pipebenitezpb1/PULSAR/docs/renders/perillas_variantes.png

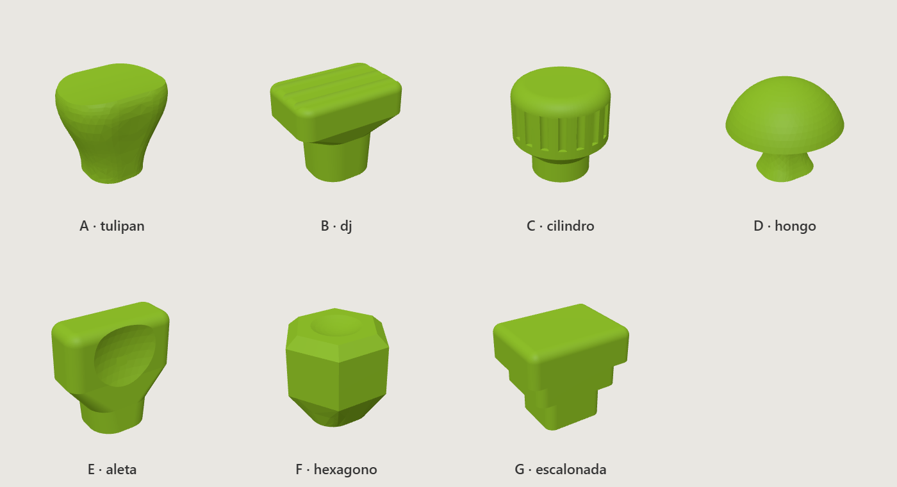
docs/renders/perillas_variantes.png
