pipebenitezpb1/PULSAR/docs/renders/vistaL_atras.png

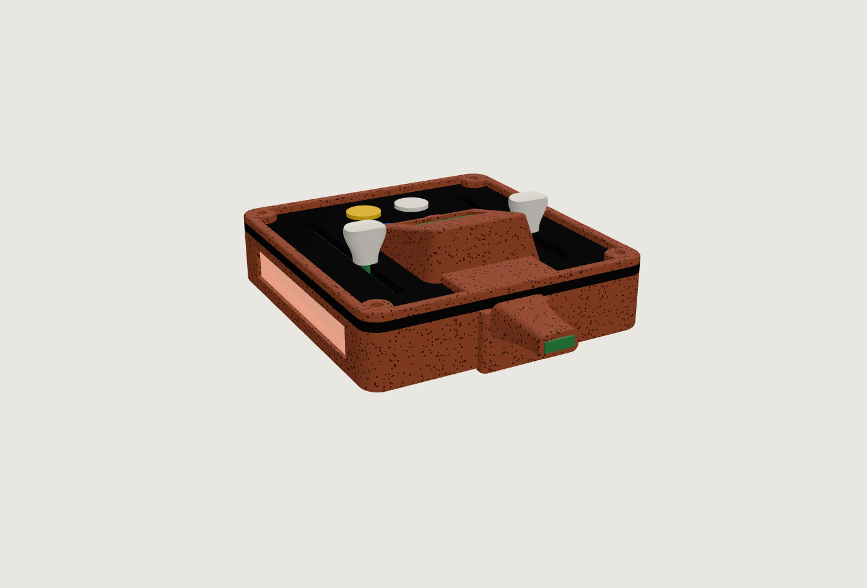
docs/renders/vistaL_atras.png
