pipebenitezpb1/PULSAR/fabricacion/impresion_3d/CTRL-04L_9_tapa_cuerpo.stl

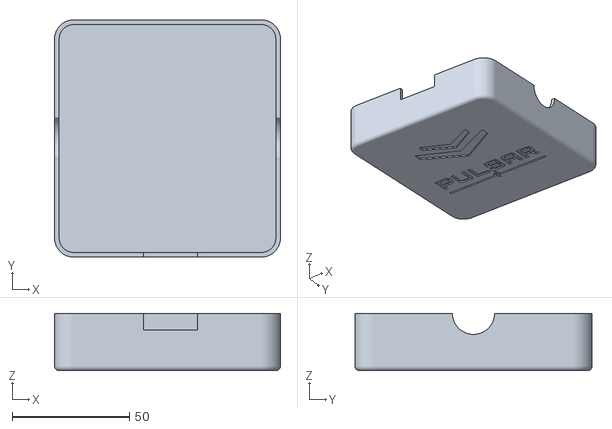
[picture p31: CAD file, 2026-10-29]
fabricacion/impresion_3d/CTRL-04L_9_tapa_cuerpo.stl
96.5 x 101.3 x 24.5
