pipebenitezpb1/PULSAR/fabricacion/laser/CTRL-04L_acrilico_3mm.step

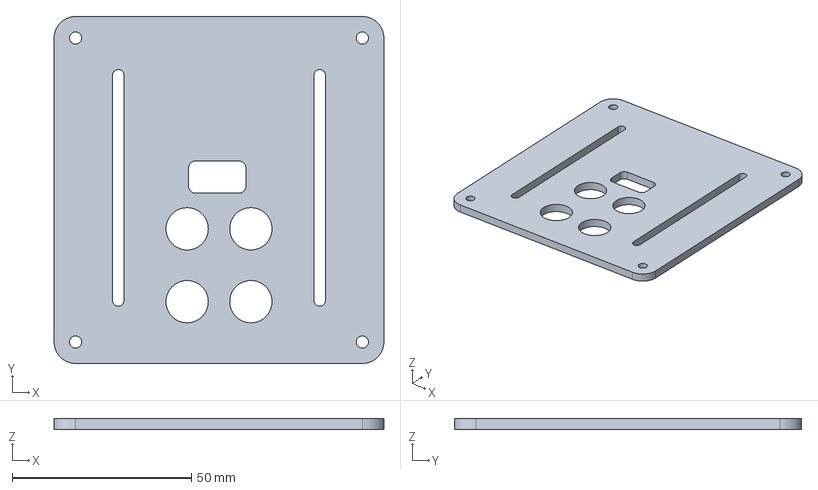
[picture p32: CAD file, 2026-10-29]
fabricacion/laser/CTRL-04L_acrilico_3mm.step
92.0 x 96.8 x 3.00 mm
