pipebenitezpb1/PULSAR/fabricacion/impresion_3d/CTRL-04L_9_tapa_acento.stl

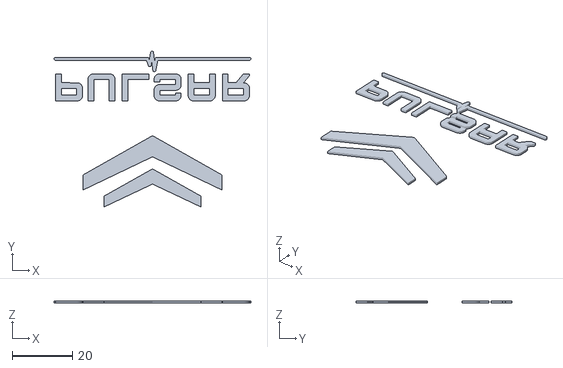
[picture p33: CAD file, 2026-10-29]
fabricacion/impresion_3d/CTRL-04L_9_tapa_acento.stl
65.3 x 51.6 x 0.8
