pipebenitezpb1/PULSAR/fabricacion/impresion_3d/CTRL-04L_9_tapa.step

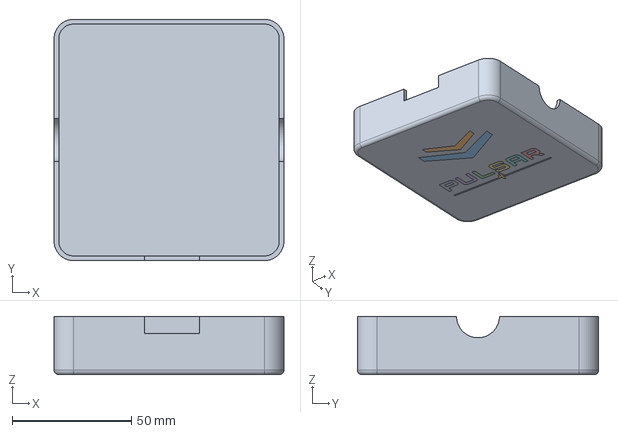
[picture p34: CAD file, 2026-10-29]
fabricacion/impresion_3d/CTRL-04L_9_tapa.step
96.5 x 101.3 x 24.5 mm
