pipebenitezpb1/PULSAR/fabricacion/impresion_3d/perilla_H_ala_cuerpo_x2.stl

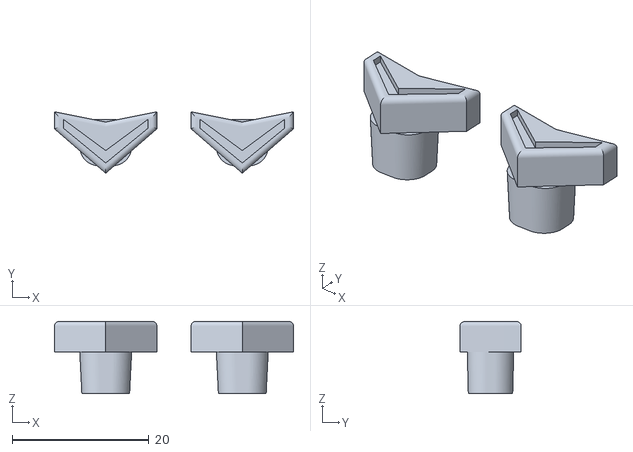
[picture p35: CAD file, 2026-10-29]
fabricacion/impresion_3d/perilla_H_ala_cuerpo_x2.stl
35.0 x 9.00 x 10.6
