pipebenitezpb1/PULSAR/fabricacion/impresion_3d/CTRL-04L_3_marco_oled.step

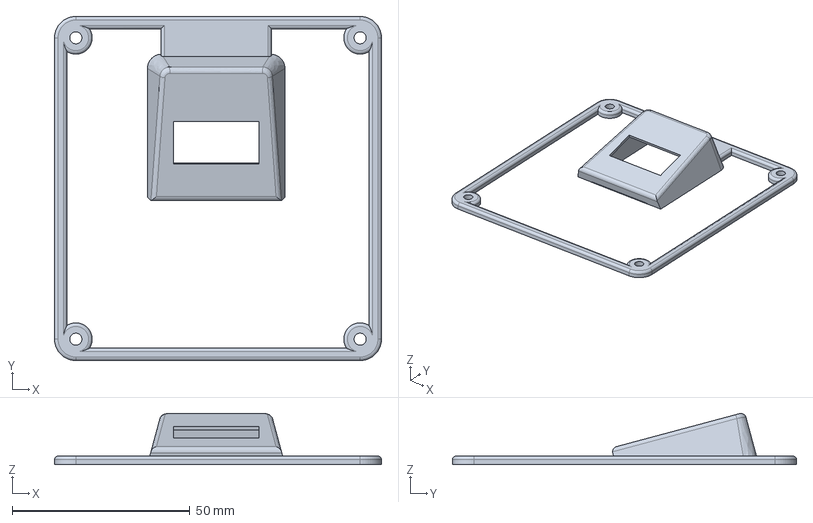
[picture p36: CAD file, 2026-10-29]
fabricacion/impresion_3d/CTRL-04L_3_marco_oled.step
92.0 x 96.8 x 14.4 mm
