pipebenitezpb1/PULSAR/fabricacion/impresion_3d/CTRL-04L_1_caja.step

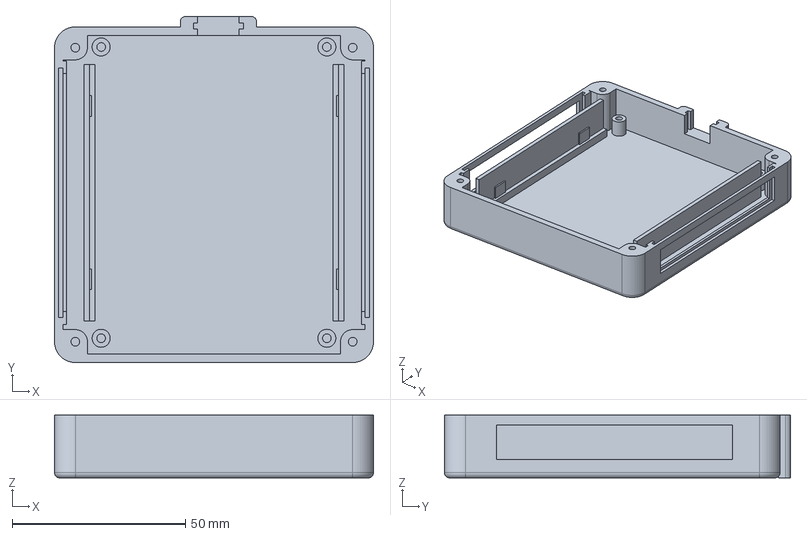
[picture p37: CAD file, 2026-10-29]
fabricacion/impresion_3d/CTRL-04L_1_caja.step
92.0 x 99.8 x 18.1 mm
