pipebenitezpb1/PULSAR/fabricacion/impresion_3d/perilla_H_ala_acento_x2.stl

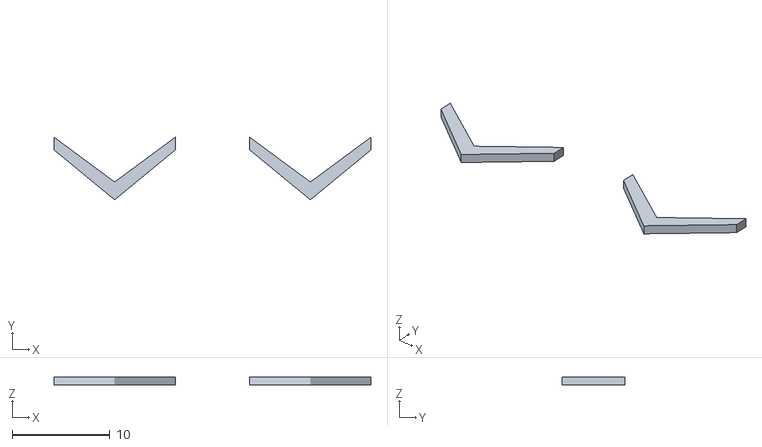
[picture p38: CAD file, 2026-10-29]
fabricacion/impresion_3d/perilla_H_ala_acento_x2.stl
32.4 x 6.40 x 0.8
