pipebenitezpb1/PULSAR/fabricacion/impresion_3d/perilla_H_ala_x2.step

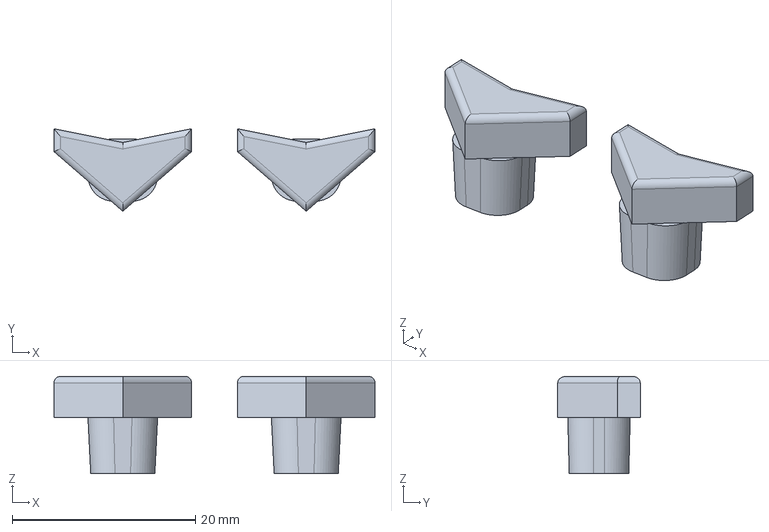
[picture p39: CAD file, 2026-10-29]
fabricacion/impresion_3d/perilla_H_ala_x2.step
35.0 x 9.00 x 10.6 mm
