pipebenitezpb1/PULSAR/fabricacion/impresion_3d/CTRL-04L_4_cuna_oled.step

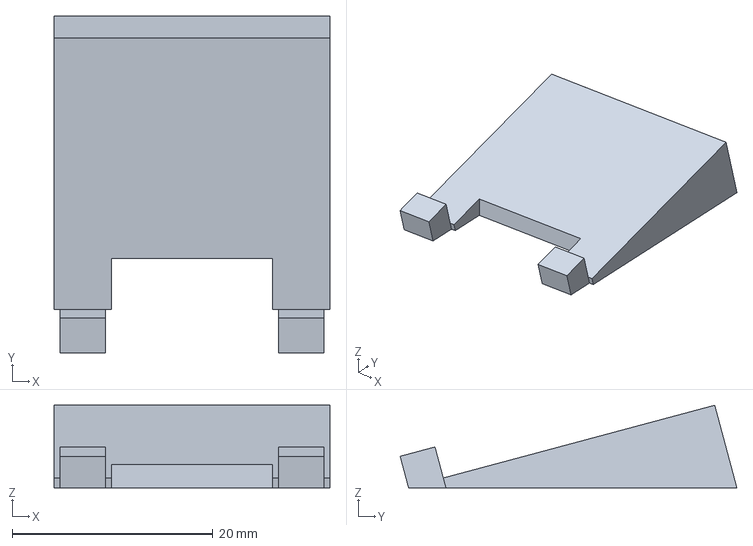
[picture p40: CAD file, 2026-10-29]
fabricacion/impresion_3d/CTRL-04L_4_cuna_oled.step
27.5 x 33.6 x 8.22 mm
