pipebenitezpb1/PULSAR/fabricacion/impresion_3d/CTRL-04L_8_patas_tpu_x6.step

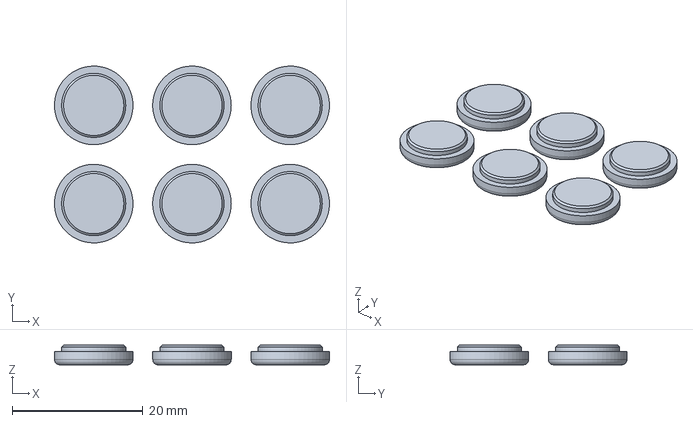
[picture p41: CAD file, 2026-10-29]
fabricacion/impresion_3d/CTRL-04L_8_patas_tpu_x6.step
42.0 x 27.0 x 3.00 mm
