pipebenitezpb1/PULSAR/fabricacion/impresion_3d/CTRL-04L_7_funda_usb.step

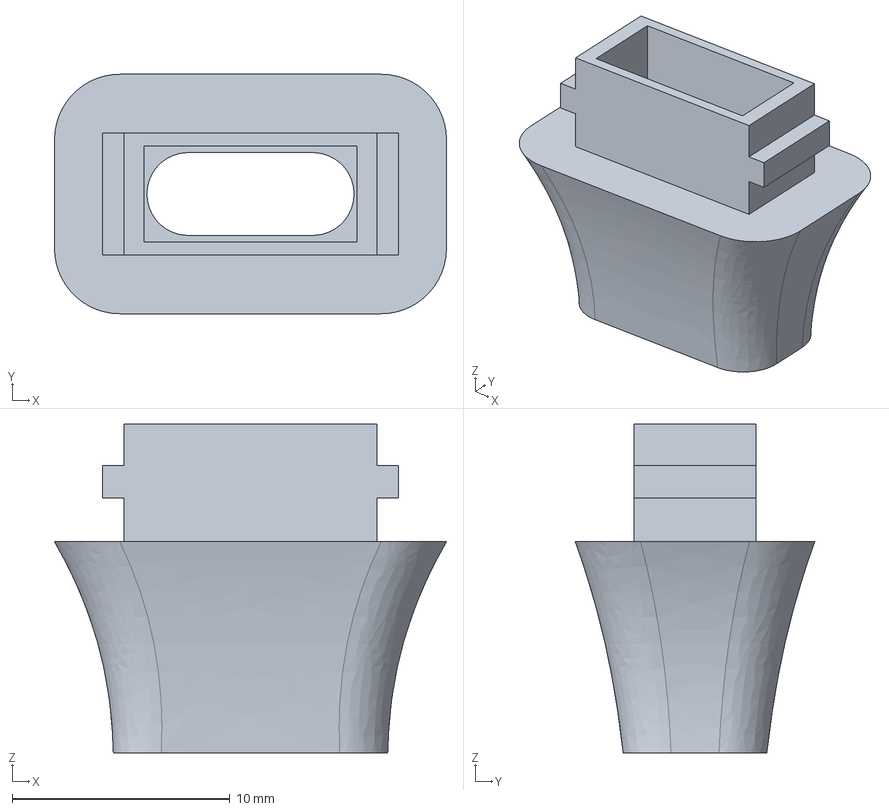
[picture p42: CAD file, 2026-10-29]
fabricacion/impresion_3d/CTRL-04L_7_funda_usb.step
18.0 x 11.0 x 15.1 mm
