pipebenitezpb1/PULSAR/fabricacion/impresion_3d/CTRL-04L_5_lamina_difusora_x2.stl

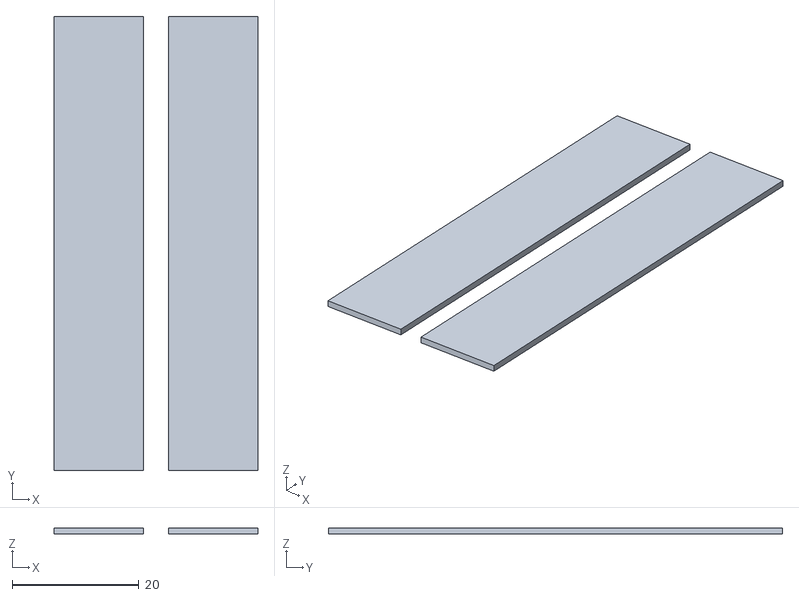
[picture p43: CAD file, 2026-10-29]
fabricacion/impresion_3d/CTRL-04L_5_lamina_difusora_x2.stl
32.1 x 71.6 x 1.00
