pipebenitezpb1/PULSAR/(list of files, cad)

Other CAD files:
fabricacion/impresion_3d/CTRL-04L_1_caja.stl
fabricacion/impresion_3d/CTRL-04L_3_marco_oled.stl
fabricacion/impresion_3d/CTRL-04L_4_cuna_oled.stl
fabricacion/impresion_3d/CTRL-04L_7_funda_usb.stl
fabricacion/impresion_3d/CTRL-04L_8_patas_tpu_x6.stl
fabricacion/laser/CTRL-04L_acrilico_3mm.dxf
