pipebenitezpb1/PULSAR/firmware/src/logo_pulsar.h

// Logo PULSAR para la OLED (generado por avanzado/logo.py, no editar a mano)
#pragma once
const int LOGO_W = 120, LOGO_H = 34;
static const unsigned char LOGO_BITS[] PROGMEM = {
  0xfe, 0xff, 0xe0, 0x01, 0x3c, 0x1e, 0x00, 0x80, 0xff, 0x0f, 0xf0, 0xff, 0x81, 0xff, 0x3f,
  0xfe, 0xff, 0xe1, 0x01, 0x3c, 0x1e, 0x00, 0xe0, 0xff, 0x1f, 0xf8, 0xff, 0x83, 0xff, 0x7f,
  0xfe, 0xff, 0xe1, 0x01, 0x3c, 0x1e, 0x00, 0xe0, 0xff, 0x1f, 0xfc, 0xff, 0x83, 0xff, 0x7f,
  0x1e, 0xc0, 0xe3, 0x01, 0x3c, 0x1e, 0x00, 0xe0, 0x01, 0x3c, 0x3c, 0x80, 0x87, 0x07, 0xf0,
  0x1e, 0xc0, 0xe3, 0x01, 0x3c, 0x1e, 0x00, 0xe0, 0x01, 0x1c, 0x3c, 0x80, 0x87, 0x07, 0xf0,
  0x1e, 0xc0, 0xe3, 0x01, 0x3c, 0x1e, 0x00, 0xe0, 0x01, 0x00, 0x3c, 0x80, 0x87, 0x07, 0xf0,
  0x1e, 0xc0, 0xe3, 0x01, 0x3c, 0x1e, 0x00, 0xe0, 0xff, 0x0f, 0x3c, 0x80, 0x87, 0x07, 0xf0,
  0xfe, 0xff, 0xe3, 0x01, 0x3c, 0x1e, 0x00, 0xe0, 0xff, 0x1f, 0x3c, 0x80, 0x87, 0xff, 0xff,
  0xfe, 0xff, 0xe1, 0x01, 0x3c, 0x1e, 0x00, 0xc0, 0xff, 0x1f, 0xfc, 0xff, 0x87, 0xff, 0x7f,
  0xfe, 0xff, 0xe1, 0x01, 0x3c, 0x1e, 0x00, 0x00, 0x00, 0x3c, 0xfc, 0xff, 0x87, 0xff, 0x7f,
  0x1e, 0x00, 0xe0, 0x01, 0x3c, 0x1e, 0x00, 0x00, 0x00, 0x3c, 0xfc, 0xff, 0x87, 0x87, 0x1f,
  0x1e, 0x00, 0xe0, 0x01, 0x3c, 0x1e, 0x00, 0xe0, 0x01, 0x3c, 0x3c, 0x80, 0x87, 0x07, 0x1f,
  0x1e, 0x00, 0xe0, 0x01, 0x3c, 0x1e, 0x00, 0xe0, 0x01, 0x3c, 0x3c, 0x80, 0x87, 0x07, 0x3e,
  0x1e, 0x00, 0xe0, 0xff, 0x1f, 0xfe, 0xff, 0xe3, 0xff, 0x1f, 0x3c, 0x80, 0x87, 0x07, 0x7c,
  0x1e, 0x00, 0xc0, 0xff, 0x1f, 0xfe, 0xff, 0xc3, 0xff, 0x1f, 0x3c, 0x80, 0x87, 0x07, 0x78,
  0x1e, 0x00, 0x80, 0xff, 0x0f, 0xfe, 0xff, 0x83, 0xff, 0x0f, 0x3c, 0x80, 0x87, 0x07, 0xf8,
  0x00, 0x00, 0x00, 0x00, 0x00, 0x00, 0x00, 0x00, 0x00, 0x00, 0x00, 0x00, 0x00, 0x00, 0x00,
  0x00, 0x00, 0x00, 0x00, 0x00, 0x00, 0x00, 0x00, 0x00, 0x00, 0x00, 0x00, 0x00, 0x00, 0x00,
  0x00, 0x00, 0x00, 0x00, 0x00, 0x00, 0x00, 0x00, 0x00, 0x00, 0x00, 0x00, 0x00, 0x00, 0x00,
  0x00, 0x00, 0x00, 0x00, 0x00, 0x00, 0x00, 0x20, 0x00, 0x00, 0x00, 0x00, 0x00, 0x00, 0x00,
  0x00, 0x00, 0x00, 0x00, 0x00, 0x00, 0x00, 0x20, 0x00, 0x00, 0x00, 0x00, 0x00, 0x00, 0x00,
  0x00, 0x00, 0x00, 0x00, 0x00, 0x00, 0x00, 0x20, 0x00, 0x00, 0x00, 0x00, 0x00, 0x00, 0x00,
  0x00, 0x00, 0x00, 0x00, 0x00, 0x00, 0x00, 0x34, 0x00, 0x00, 0x00, 0x00, 0x00, 0x00, 0x00,
  0x00, 0x00, 0x00, 0x00, 0x00, 0x00, 0x00, 0x54, 0x00, 0x00, 0x00, 0x00, 0x00, 0x00, 0x00,
  0x00, 0x00, 0x00, 0x00, 0x00, 0x00, 0x00, 0x56, 0x00, 0x00, 0x00, 0x00, 0x00, 0x00, 0x00,
  0x00, 0x00, 0x00, 0x00, 0x00, 0x00, 0x00, 0x56, 0x00, 0x00, 0x00, 0x00, 0x00, 0x00, 0x00,
  0xff, 0xff, 0xff, 0xff, 0xff, 0xff, 0xff, 0xd9, 0xff, 0xff, 0xff, 0xff, 0xff, 0xff, 0xff,
  0x00, 0x00, 0x00, 0x00, 0x00, 0x00, 0x00, 0x18, 0x00, 0x00, 0x00, 0x00, 0x00, 0x00, 0x00,
  0x00, 0x00, 0x00, 0x00, 0x00, 0x00, 0x00, 0x08, 0x00, 0x00, 0x00, 0x00, 0x00, 0x00, 0x00,
  0x00, 0x00, 0x00, 0x00, 0x00, 0x00, 0x00, 0x08, 0x00, 0x00, 0x00, 0x00, 0x00, 0x00, 0x00,
  0x00, 0x00, 0x00, 0x00, 0x00, 0x00, 0x00, 0x08, 0x00, 0x00, 0x00, 0x00, 0x00, 0x00, 0x00,
  0x00, 0x00, 0x00, 0x00, 0x00, 0x00, 0x00, 0x00, 0x00, 0x00, 0x00, 0x00, 0x00, 0x00, 0x00,
  0x00, 0x00, 0x00, 0x00, 0x00, 0x00, 0x00, 0x00, 0x00, 0x00, 0x00, 0x00, 0x00, 0x00, 0x00,
  0x00, 0x00, 0x00, 0x00, 0x00, 0x00, 0x00, 0x00, 0x00, 0x00, 0x00, 0x00, 0x00, 0x00, 0x00,
};
