pipebenitezpb1/PULSAR/(commit log)

2026-10-29 CTRL-04L: controlador físico, shield, carcasa, firmware y dashboard web
    [CTRL-04L_1_caja.step, CTRL-04L_1_caja.stl, CTRL-04L_3_marco_oled.step, CTRL-04L_3_marco_oled.stl, CTRL-04L_4_cuna_oled.step, CTRL-04L_4_cuna_oled.stl, CTRL-04L_5_lamina_difusora_x2.stl, CTRL-04L_7_funda_usb.step]
2026-10-29 Animaciones espaciales en la OLED
2026-10-29 Arreglo: el arranque le quitaba el pull-up al botón blanco
    [main.cpp]
2026-10-29 Manual de uso
2026-10-29 Manual en PDF para imprimir (blanco y negro)
2026-10-29 MIDI, espejo de la OLED, récords y manual en cuadernillo
2026-10-29 Espejo de la OLED sin estirar; cuadernillo separado para doble cara manual
2026-10-29 Cuadernillo en hojas verticales + frentes y dorsos para doble cara manual
2026-10-29 Tapa protectora a dos colores
    [CTRL-04L_9_tapa.step, CTRL-04L_9_tapa_acento.stl, CTRL-04L_9_tapa_cuerpo.stl]
2026-10-29 Nuevo nombre: PULSAR (modelo CTRL-04L)
    [CTRL-04L_9_tapa.step, CTRL-04L_9_tapa_acento.stl, CTRL-04L_9_tapa_cuerpo.stl]
2026-10-29 Logo PULSAR con Orbitron y línea de pulso: tapa, OLED, web y manual
    [CTRL-04L_9_tapa.step, CTRL-04L_9_tapa_acento.stl, CTRL-04L_9_tapa_cuerpo.stl]
2026-10-29 Apagar manteniendo el blanco 5 s; manual final
2026-10-29 Fotos de proceso: evolución del diseño (13 fotos)
2026-10-29 Foto 20: piezas de las iteraciones
